patrickmetzner/betaLogger/Segers.PNG

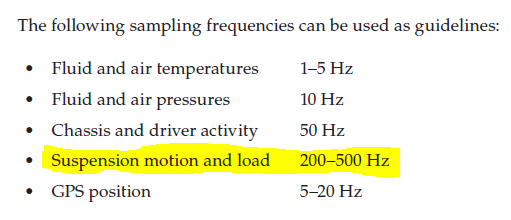
Segers.PNG
