patrickmetzner/betaLogger/STM.jpg

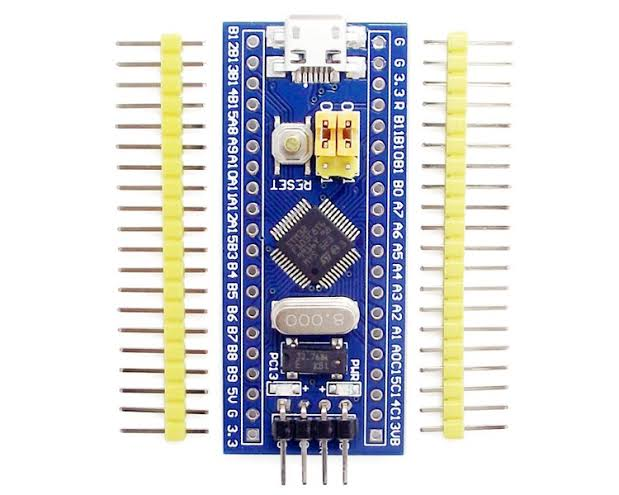
STM.jpg
