patrickmetzner/betaLogger/betaLogger esquemático.pdf

## MPU1

## GPS1

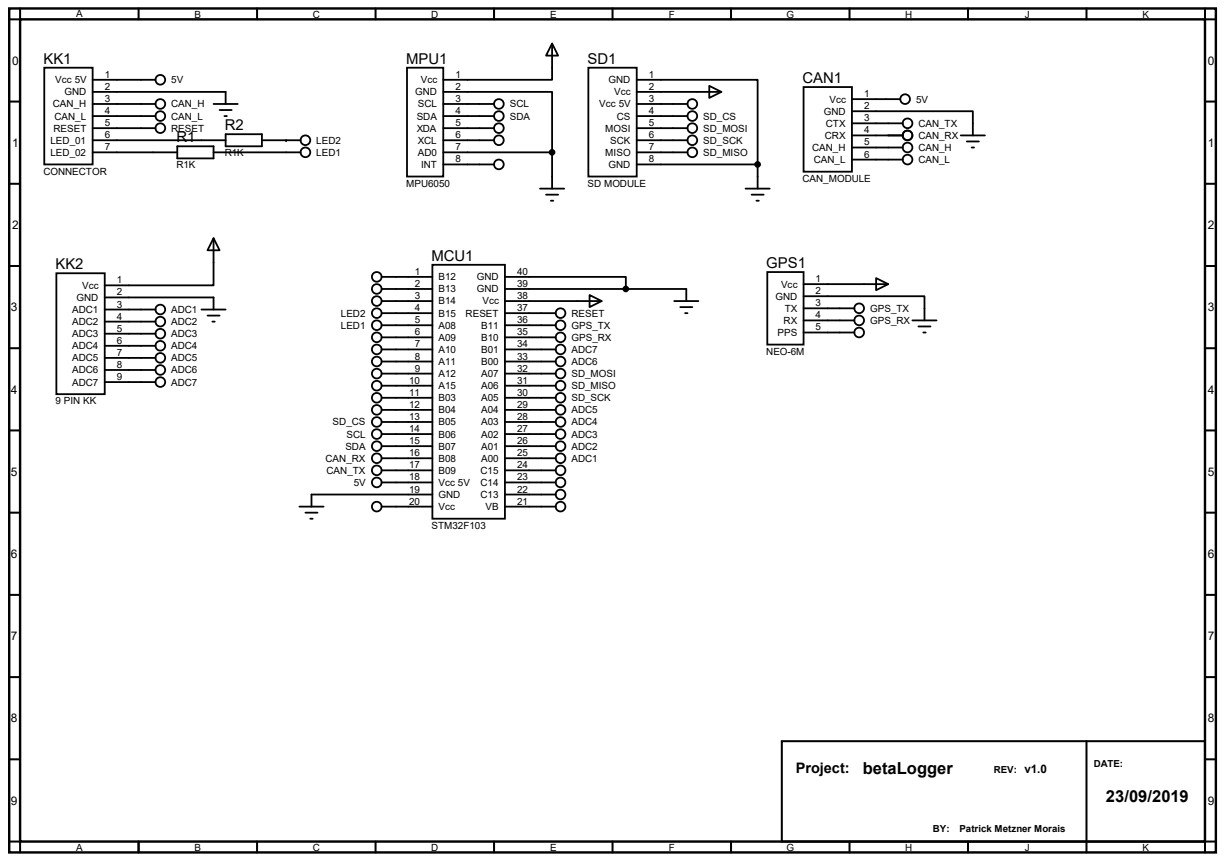
[picture p15: page 1]
DATE:; Project: betaLogger; REV: v1.0; Vcc; GND; SCL; SDA; XDA; XCL; INT; MPU6050; PPS; NEO-6M; Vcc 5V; MOSI; SCK; MISO; SD MODULE; B12 1 B13 2 B14 3 B15 4 A08 5 A09 6 A10 7 A11 8 A12 9 A15 10 B03 11 B04 12 B05 13 B06 14 B07 15 B08 16 B09 17 Vcc 5V 18 GND 19 Vcc 20; RESET; MCU1; STM32F103; ADC1; ADC2; ADC3; ADC4; ADC5; ADC6; ADC7; 9 PIN KK; CAN_H CAN_L RESET; LED2 LED1; SD_MOSI SD_SCK SD_MISO; GPS_TX GPS_RX; SD_CS SCL SDA CAN_RX CAN_TX; SD_SCK; SD_MISO; SD_MOSI; GPS_RX; GPS_TX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

Patrick Metzner Morais
