patrickmetzner/betaLogger/(list of files, drawings)

Other design files:
betaLogger.pdsprj
