patrickmetzner/betaLogger/betaLogger_V2.0/Inc/main.h

#define NLED_Pin GPIO_PIN_13
#define NLED_GPIO_Port GPIOC
#define BOOT1_Pin GPIO_PIN_2
#define BOOT1_GPIO_Port GPIOB
#define DEBUG5_Pin GPIO_PIN_12
#define DEBUG5_GPIO_Port GPIOB
#define DEBUG4_Pin GPIO_PIN_13
#define DEBUG4_GPIO_Port GPIOB
#define DEBUG3_Pin GPIO_PIN_14
#define DEBUG3_GPIO_Port GPIOB
#define DEBUG2_Pin GPIO_PIN_15
#define DEBUG2_GPIO_Port GPIOB
#define DEBUG1_Pin GPIO_PIN_8
#define DEBUG1_GPIO_Port GPIOA
#define DEBUG6_Pin GPIO_PIN_15
#define DEBUG6_GPIO_Port GPIOA
#define SPI1_CS_Pin GPIO_PIN_5
#define SPI1_CS_GPIO_Port GPIOB
